ThomasXin50/teleop_board/(list of files, drawings)

Other design files:
Teleoperation_V1.1/clutch_interface.SchDoc
Teleoperation_V1.1/motor_interfaces.SchDoc
Teleoperation_V1.1/PCB1.PcbDoc
Teleoperation_V1.1/power.SchDoc
Teleoperation_V1.1/rp2040.SchDoc
Teleoperation_V1.1/Teleoperation_Board_V1.0.PcbLib
Teleoperation_V1.1/Teleoperation_V1.1.PrjPcb
Teleoperation_V1.1/Top.SchDoc
Teleoperation_V1.1/voltage_dividers.SchDoc
